HanRabbit/FlexBall/Hardware/UART串口传输协议1.jpg

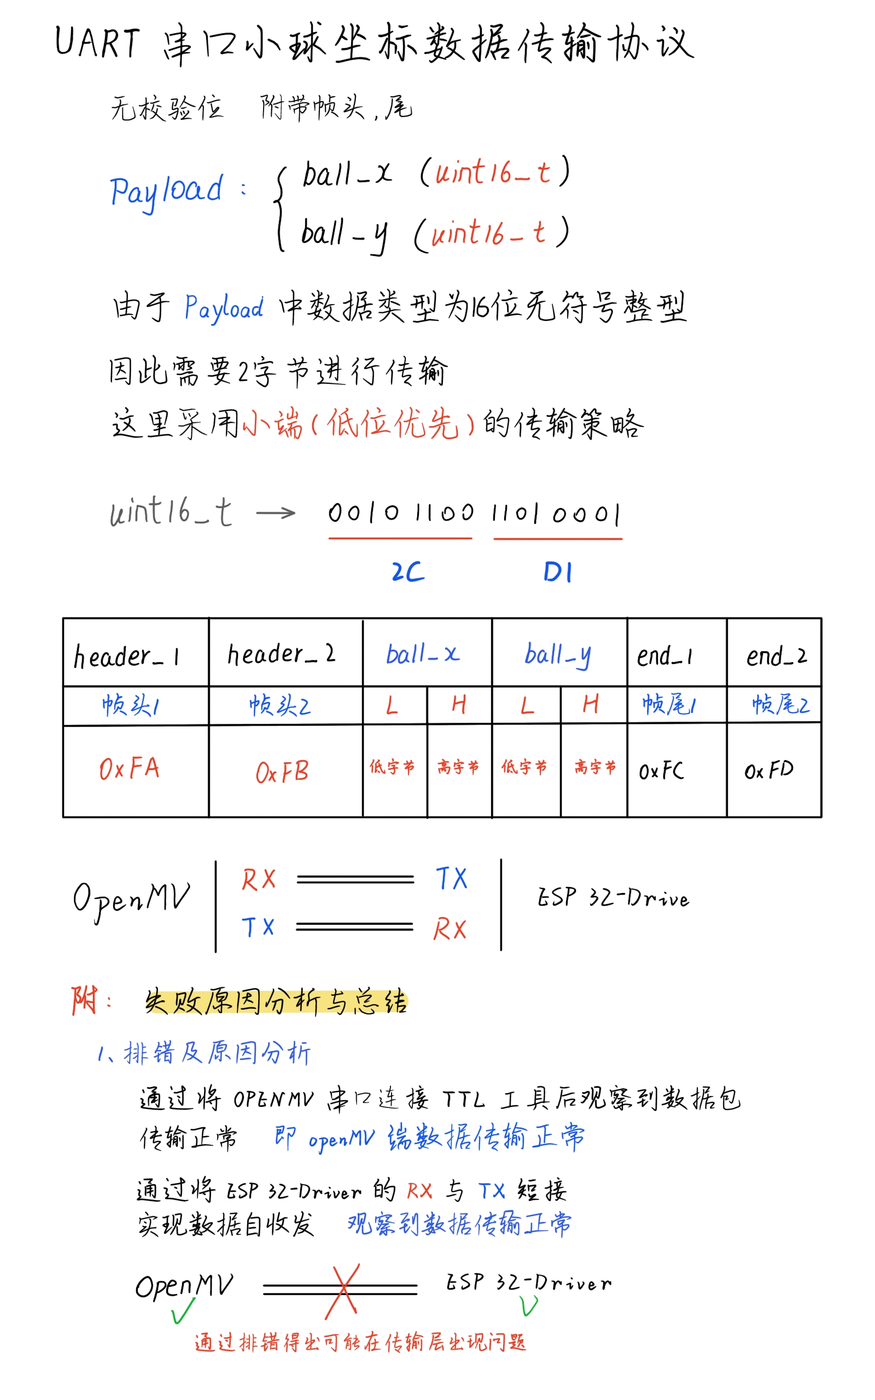
Hardware/UART串口传输协议1.jpg
