HanRabbit/FlexBall/Hardware/UART串口传输协议2.jpg

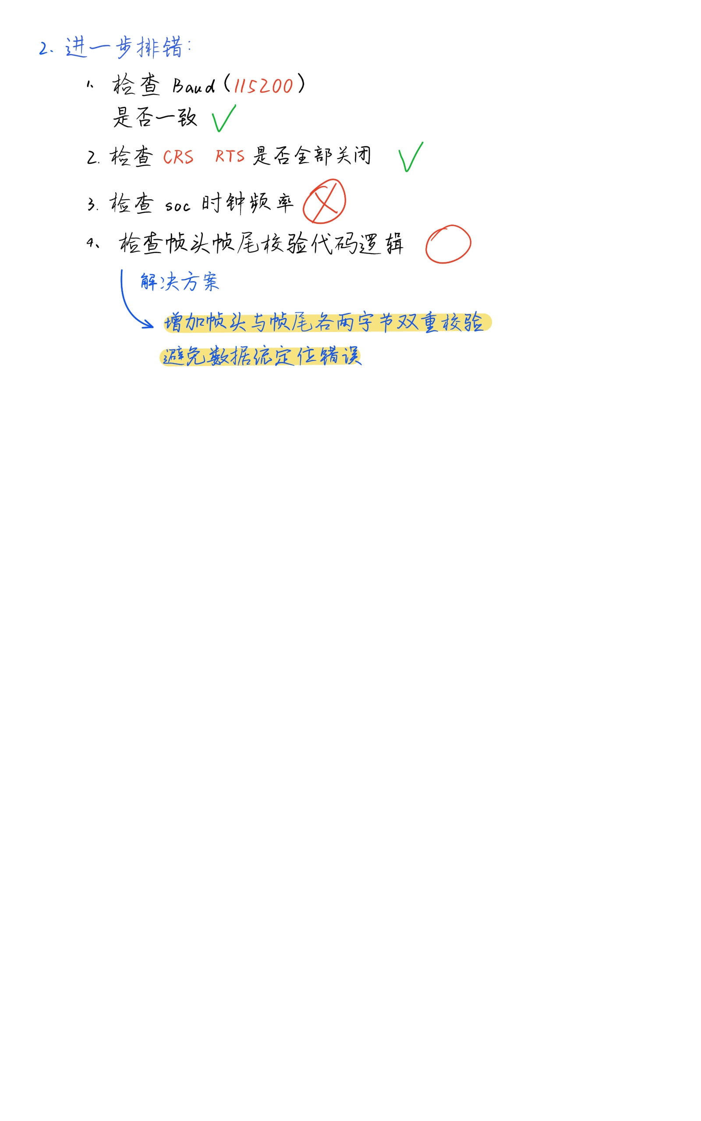
Hardware/UART串口传输协议2.jpg
