HanRabbit/FlexBall/Hardware/线框图.png

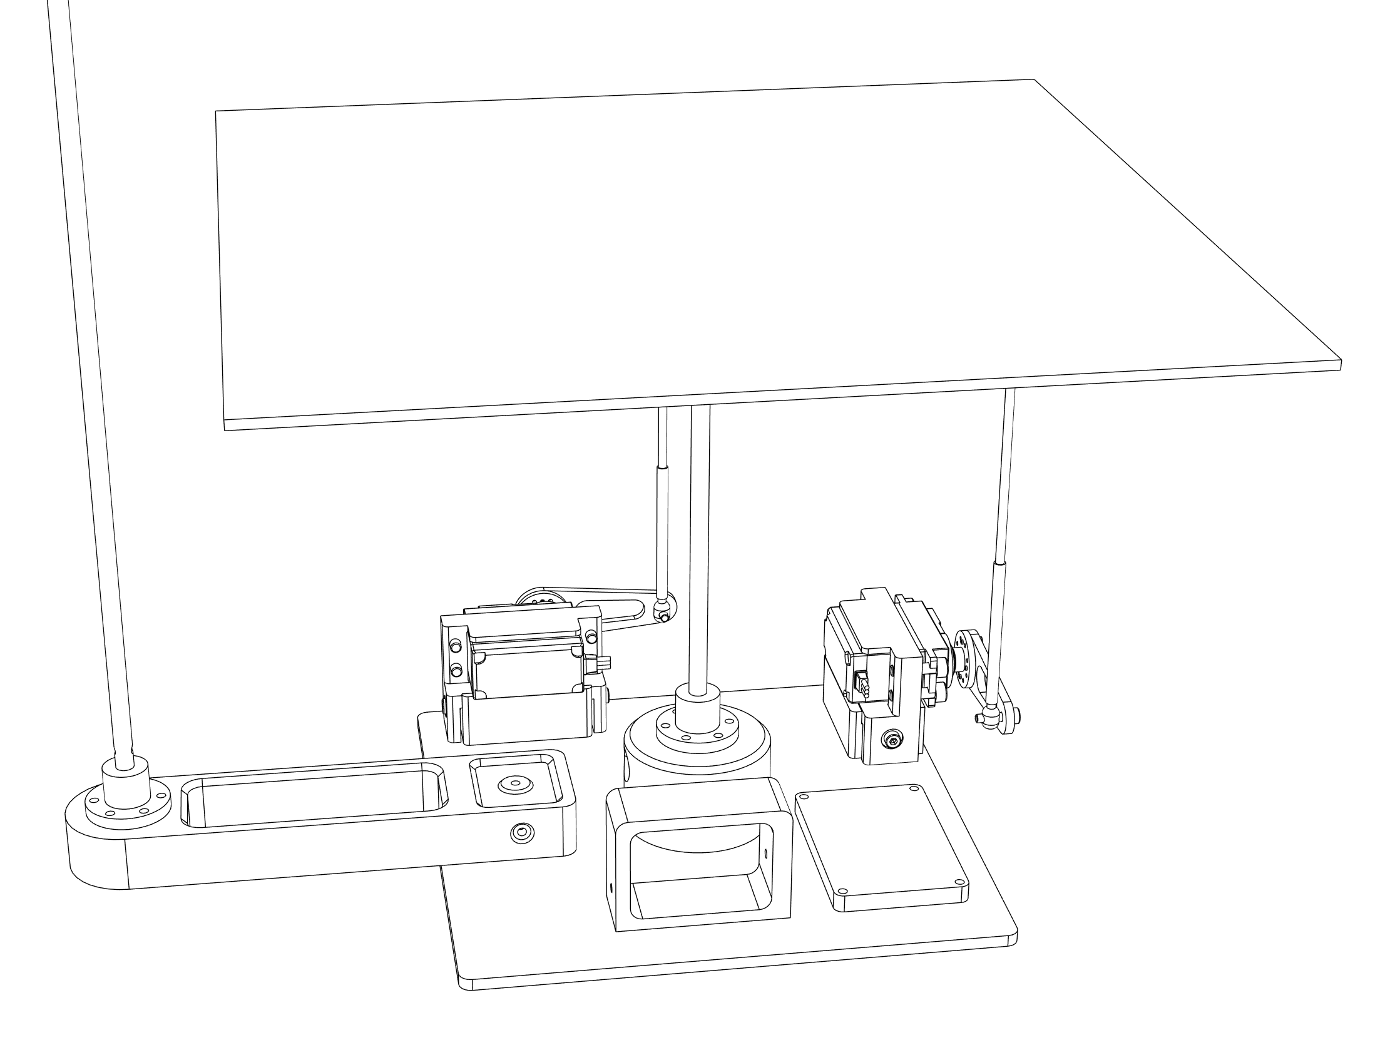
Hardware/线框图.png
