HanRabbit/FlexBall/Hardware/Flex-Ball Main.step

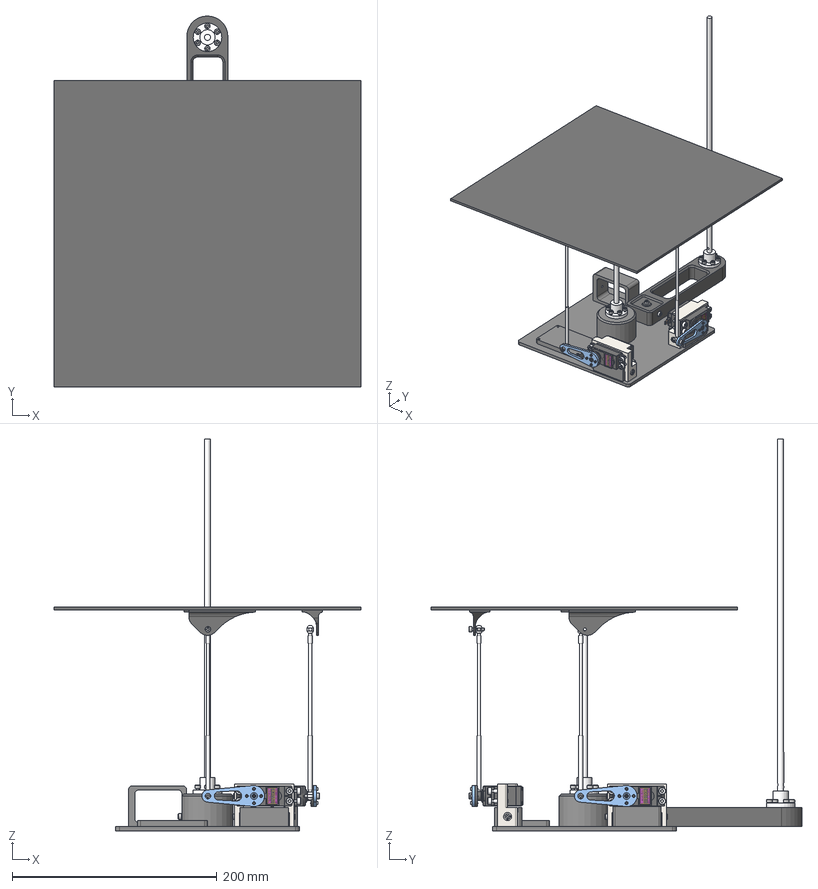
[picture p6: CAD file, 2025-06-12]
Hardware/Flex-Ball Main.step
300.0 x 362.8 x 383.0 mm
舵机臂 x 2
FSHCS ASME B18.3.1M - M1.6x0.35 x 6 钢等级 2 平垫圈 x 8
CS JIS B 1122 - ST2.9 x 6.5 - F - Z 钢 4.6 平垫圈 x 2
舵机支架 x 2
BSHCS ASME B18.3.1M - M4x0.7 x 16 钢等级 2 平垫圈 x 8
BSHCS ANSI B18.3.1M - M3x0.5 x 12 钢等级 2 平垫圈 x 4
黑色尼龙板
万向节连接件
万向节下
万向节上
底座
BSHCS ASME B18.3.1M - M3x0.5 x 12 钢等级 2 平垫圈 x 18
连杆1
连杆支架1
连杆支架2
连杆2
